tyin-source/Lab-Module-4/docs/module_notes/module_04_high_current_path.md

# Module 4 Part 1: High-Current Path (for instructor inspection)

Source: the Module 3 wiring record in `joshuaaferiat/Lab-Module-3`,
`docs/module_notes/module_03_tec_gui.md` (Part 1). **Before asking for approval,
re-check each item on the physical apparatus.** The actual wiring counts, not
this drawing.

## Diagram

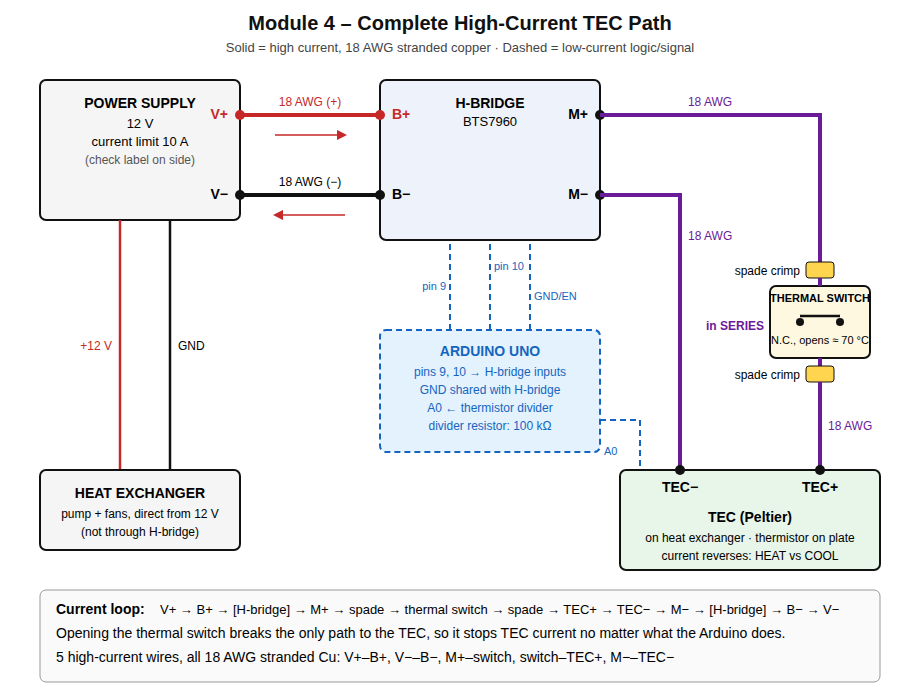
[picture p2: docs/figures/module_04/high_current_path.png]
Complete high-current path


Vector source: `docs/figures/module_04/high_current_path.svg`. Text version:

Solid lines (`│ ─`) carry high current: 18 AWG stranded copper.
Dotted lines (`┊ ┈`) are low-current logic wiring and are not part of the high-current path.

```
        ┌──────────────────────────────────────────┐
        │            POWER SUPPLY                  │
        │   Voltage: 12 V    Current limit: 10 A   │
        │        V+ (+)              V− (−)        │
        └─────────┬───────────────────┬────────────┘
                  │ 18 AWG            │ 18 AWG
                  │                   │
                  ├───────────────────┼──────────► Heat exchanger (pump + fans)
                  │                   │            powered directly from 12 V
                  │                   │            (NOT through H-bridge)
                  ▼                   ▼
        ┌─────── B+ ───────────────── B− ─────────┐
        │                                         │
        │        H-BRIDGE  (BTS7960)              │◄┈┈┈ Arduino pin 9  (PWM/LOW)
        │                                         │◄┈┈┈ Arduino pin 10 (PWM/LOW)
        │                                         │◄┈┈┈ Arduino GND (shared logic ground)
        └─────── M+ ───────────────── M− ─────────┘
                  │ 18 AWG            │ 18 AWG
                  │                   │
            ┌─────┴──────┐            │
            │  [spade]   │            │
            │  THERMAL   │  normally closed,
            │  SWITCH    │  in SERIES with TEC,
            │  (NC)      │  opens at ≈ 70 °C
            │  [spade]   │            │
            └─────┬──────┘            │
                  │ 18 AWG            │
                  ▼                   │
        ┌──────── TEC+ ─────────── TEC− ──────────┐
        │                  TEC                    │
        │      (thermistor plate / heat sink)     │
        └─────────────────────────────────────────┘

Current loop:
  PSU V+ → B+ → [H-bridge] → M+ → thermal switch → TEC+ → TEC → TEC− → M− → [H-bridge] → B− → PSU V−
  (In the other direction, current flows M− → TEC− → TEC → TEC+ → switch → M+.)
```

Opening the thermal switch breaks the M+ → TEC+ leg, so TEC current stops no
matter what the Arduino commands.

## Checklist for the instructor

| Item | Value / what to show | Verified today? |
| --- | --- | --- |
| Wire gauge | 18 AWG stranded Cu on all 5 high-current wires: V+→B+, V−→B−, M+→switch, switch→TEC+, TEC−→M− (the two switch wires end in the spade crimps) | ☑ |
| Supply polarity | V+ → B+, V− → B− | ☑ |
| TEC polarity | M+ → (switch) → TEC+; TEC− → M− | ☑ |
| Spade crimps | Both female spades on the thermal switch are secure (tug test) | ☑ |
| Thermal-switch continuity | Multimeter beeps / reads ≈ 0 Ω across the closed switch | ☑ |
| Thermal-switch placement | In series in the M+ → TEC+ leg, nothing bypasses it | ☑ |
| Supply settings | 12 V, current limit 10 A (check the label on the side of the supply) | ☑ |
| H-bridge outputs checked with TEC power off (Module 3) | Pins 9/10 checked with the scope, TEC power off | ☑ |
| Logic ground | Arduino GND shared with H-bridge logic ground | ☑ |
| Direction mapping | Heating = PWM on pin 9 ; Cooling = PWM on pin 10 (confirmed in the TEC start-up test) | ☑ |

## Module 4 changes from Module 3

| Item | Module 3 | Module 4 |
| --- | --- | --- |
| Thermistor divider external resistor (5 V to A0; thermistor from A0 to GND) | 100 kΩ | **100 kΩ** (unchanged; `SERIES_RESISTOR = 100000.0`) |
| Raw readings averaged per temperature | 200 | 1000 (`ADC_SAMPLES`) |
| Serial update interval | 0.2 s | about 1 s (one line per 1000-reading average) |
| Software temperature limit | none | 60 °C (`TEMP_LIMIT_C`): above it, both H-bridge PWM outputs are set to 0 |
| Measurement line | ends at `Heat/Cool` | adds `, Safety shutdown: 0/1` |
| GUI temperature axis | fixed 15–45 °C | autoscaled to the visible window: 1 °C below the minimum to 1 °C above the maximum, at least a 6 °C span; white background |
| GUI CSV | one file, overwritten each run | a new file per run: `data/module_04/module4_run_<date>_<time>.csv` |

## Files and settings for the module notes

| Item | Value |
| --- | --- |
| Arduino sketch | `arduino/module4_tec_control/module4_tec_control.ino` (9600 baud, 60 °C limit) |
| Interlock test sketch | `arduino/module4_tec_control_limit30_test/module4_tec_control_limit30_test.ino` (identical except 30 °C limit) |
| Python GUI | `python/module4_control_gui.py` |
| Serial port | `COM5` (Windows lab computer; Module 3 recorded `COM4` on Windows and `/dev/cu.usbmodem1101` on macOS) |
| Power-supply voltage | 12 V (from the supply label, recorded in the Module 3 notes) |
| Power-supply current limit | 10 A (from the supply label, recorded in the Module 3 notes) |

## Verifying the software temperature limit (TEC power still OFF)

**Result: done in class.** The 30 °C test sketch was uploaded and the thermistor was warmed by
hand above 30 °C. The serial output switched to `SAFETY SHUTDOWN ACTIVE`, the measurement lines
showed `PWM: 0` and `Safety shutdown: 1`, and both H-bridge PWM outputs were zero. After the
thermistor cooled below 30 °C, PWM stayed at 0 until a new command was sent. The 60 °C sketch
was then uploaded again and shown to the instructor (`SAFETY: software temperature limit (C): 60.00`).
The apparatus was never heated to 60 °C. The hardware thermal switch stays in series as the
independent final protection.

Procedure used:

1. Upload the 30 °C test sketch (`TEMP_LIMIT_C = 30.0`). The GUI terminal shows
   `SAFETY: software temperature limit (C): 30.00`.
2. Set a nonzero PWM (for example 100) in the GUI so there is an output to shut off.
3. Warm the thermistor with your fingers until the averaged temperature passes 30 °C.
4. Confirm that the terminal prints `SAFETY SHUTDOWN ACTIVE ...`, the lines show `PWM: 0`
   and `Safety shutdown: 1`, the GUI banner turns red, and the PWM trace drops to 0.
   Optionally check that pins 9 and 10 both read 0 V.
5. Move the PWM slider: the Arduino keeps `PWM: 0` while the shutdown is active.
6. Let the thermistor cool below 30 °C: the terminal prints `SAFETY SHUTDOWN CLEARED ...`
   and PWM stays 0 until you send a new command.
7. Upload `module4_tec_control.ino` (60 °C) again and show the instructor the `60.00` start-up line.

## TEC start-up test and Part 2 endpoint PWM values (9/30)

Room temperature 22.58 °C. Before the TEC was powered, the apparatus read 25.07 °C and was
slowly falling toward room temperature.

| Direction | PWM | Steady temperature | PWM trace colour | Target, with allowed error |
| --- | --- | --- | --- | --- |
| COOL | 80 | 9.93 °C | blue | 10 °C ± 1 °C: OK |
| HEAT | 47 | 45.24 °C | red | 45 °C ± 2 °C: OK |

These two runs set the maximum useful PWM for each direction (Part 2): HEAT 47 and COOL 80.
The five values per direction are 0, 25, 50, 75 and 100 % of that maximum:
HEAT 0 / 12 / 24 / 35 / 47 and COOL 0 / 20 / 40 / 60 / 80.

## Part 3: Steady-state measurements

### How steady state was decided

The lab's rule: estimate the time constant τ from a PWM step, wait about 3 τ (95 % of the change
is then complete), then watch the trace for one more minute. The temperature counts as steady when
its net drift over that minute is no larger than the ordinary short-term noise. The GUI's
autoscaled temperature axis (at least 6 °C span) was added after these measurements; it makes a
slow drift easier to see in later runs.

`python/steady_state_analysis.py` applies the same rule to a saved run CSV:

1. For each PWM step it fits `T(t) = T_ss + (T_start − T_ss)·exp(−(t − t_step)/τ)` to get τ.
2. Over the last 60 s of the step it fits a straight line. Net drift = |slope| × 60 s, and
   noise = standard deviation of the points about that line.
3. The step is steady when the time waited is at least 3 τ **and** the net drift is at most
   2 × noise (2σ is about the size of the usual up-and-down wiggles).

Run it with `python python/steady_state_analysis.py data/module_04/module4_run_<date>_<time>.csv`.
It prints τ, 3 τ, the time waited, drift, noise and a steady yes/no for every step. A step that
does not change the temperature (for example PWM 0 at the start) has no meaningful τ.

### Criterion actually used

After each PWM step we waited about 3 τ, then watched the trace for one more minute. The
temperature was recorded as steady when it stayed within **±0.1 °C** for that whole minute.
±0.1 °C is about the size of the trace's ordinary short-term noise with 1000-reading averaging, so
this is a concrete form of the lab's rule (net drift over the minute no larger than the noise). If
the trace drifted or fluctuated outside ±0.1 °C, we kept waiting and checked another minute; if it
kept fluctuating (HEAT 24, first attempt), the step was repeated.

Figure caption used in A2:

> Steady state: after each PWM step we waited about three time constants (τ ≲ 100 s), then
> watched the strip chart for one more minute. A temperature was recorded as steady when it stayed
> within ±0.1 °C (about the normal measurement noise) for that whole minute. Waits were 370–725 s.

### Data table

Each step started from the previous step's steady temperature, so each start temperature equals
the steady temperature in the row above. Both directions start from the same zero-PWM state.

| Direction | PWM | Start Temperature (°C) | Steady Temperature (°C) | Time Waited (s) | Notes |
| --- | ---: | ---: | ---: | ---: | --- |
| Heat | 0 | 23.48 | 23.48 | 174 | zero-PWM reference |
| Heat | 12 | 23.48 | 28.90 | 725 |  |
| Heat | 24 | 28.90 | 35.35 | 530 | first attempt kept fluctuating outside ±0.1 °C for 1400 s; the step was retested and reached steady state in about 530 s |
| Heat | 35 | 35.35 | 40.40 | 448 |  |
| Heat | 47 | 40.40 | 46.10 | 494 |  |
| Cool | 0 | 23.48 | 23.48 | 174 | zero-PWM reference |
| Cool | 20 | 23.48 | 20.30 | 372 |  |
| Cool | 40 | 20.30 | 16.82 | 400 |  |
| Cool | 60 | 16.82 | 13.25 | 528 |  |
| Cool | 80 | 13.25 | 9.83 | 370 | repeated after the loose L_EN / LPWM wires were reseated |

Both directions share the same zero-PWM measurement (174 s at PWM 0).

The waits were set by watching the strip chart until the steady-state rule was met,
not by a fixed timer, so they vary from 370 s to 725 s. At HEAT 24 the first attempt kept
fluctuating outside ±0.1 °C even after 1400 s, so that step was retested; the retest reached
steady state in about 530 s, and its value is the one in the table. τ was not fitted separately
for each step. Every step met the rule (about 3 τ plus a final minute with no drift beyond the noise)
within its recorded wait, so the shortest waits (370–372 s) put an upper limit on τ:
3 τ + 60 s ≤ 370 s gives τ ≲ 100 s. To get τ directly, run
`steady_state_analysis.py` on a saved run CSV.

### Why the endpoint test and the step series differ slightly

The Part 2 endpoint test (9/30) and the Part 3 step-by-step series were done on two different days:

| | Part 2 endpoints (9/30) | Part 3 series |
| --- | ---: | ---: |
| Zero-PWM / room reference | room 22.58 °C | zero-PWM steady 23.48 °C |
| COOL PWM 80 | 9.93 °C | 9.83 °C |
| HEAT PWM 47 | 45.24 °C | 46.10 °C |

At steady state `T = T_0 + χ_T·u`, where the zero-PWM temperature `T_0` is set by that day's room
temperature and heat-exchanger conditions. A different day shifts `T_0` and moves the whole
curve up or down, but it does not change how much the temperature moves per PWM count. This does
not affect the results:

- **Part 2 only selected the maximum PWM values.** Both series stay inside the allowed windows on
  both days (10 °C ± 1 °C and 45 °C ± 2 °C), so the same maxima (COOL 80, HEAT 47) apply.
- **All fitted points come from one day.** The slopes m_h and m_c, and their ratio r, are
  differences within the Part 3 series, measured from that day's own `T_0`. A day-to-day offset
  cancels out of them.
- **The differences are small:** 0.10 °C (cool) and 0.86 °C (heat), about what a ~1 °C change
  in room temperature produces.

## Part 4: Steady-state temperature vs PWM

Data: `data/module_04/part4_steady_state.csv`. Script: `python/part4_temp_vs_pwm.py`.
Signed PWM: positive = HEAT, negative = COOL.

Temperature vs signed PWM

| Direction | Signed PWM | Steady temperature (°C) |
| --- | --- | --- |
| COOL | −80 / −60 / −40 / −20 | 9.83 / 13.25 / 16.82 / 20.30 |
| Off | 0 | 23.48 |
| HEAT | 12 / 24 / 35 / 47 | 28.90 / 35.35 / 40.40 / 46.10 |

Linear fits: m_h = 0.485 °C/count (heating), m_c = 0.172 °C/count (cooling), r = m_h / m_c ≈ 2.8.
Both directions are close to linear. Heating is stronger because Joule heating (∝ I²) adds to
the Peltier heat when heating and opposes it when cooling.

These runs were on a different day from the 9/30 endpoint test, so the end points differ
slightly; see "Why the endpoint test and the step series differ slightly" in Part 3.

### Wiring fault found during the measurements

During the cooling measurements, the temperature reading became unstable and drifted, and the PWM
drive to the TEC was intermittent. We first suspected a short circuit. Because the problem was most
obvious in the cooling direction, we checked the logic wiring on the H-bridge's left side. Wiggling
the wires one at a time while running at low PWM showed that both the L_EN wire and the LPWM wire
(Arduino pin 10) were loose. A loose L_EN intermittently disables the left half-bridge, which
interrupts TEC current in both directions. A loose LPWM interrupts only the cooling PWM, because
LPWM is held LOW during heating anyway. Together they explain why the cooling direction was affected
most. After both wires were reseated, the cooling response was stable and the measurements were
repeated. The fault was located with this wiggle test, not confirmed with an oscilloscope.

## Resolved items

1. **Thermal-switch rating: resolved.** The Module 3 notes said 65 °C; the hardware thermal
   switch opens near **70 °C**, as the Module 4 handout states. Two independent protection
   levels: the software limit in the Arduino sketch shuts off both H-bridge PWM outputs above
   **60 °C**, and if the software fails, the normally closed thermal switch in series with the
   TEC opens near **70 °C** and cuts TEC current regardless of the Arduino.
2. **Direction mapping: resolved.** The Module 3 notes say HEAT = PWM on pin 10, but the
   sketch uses `HEAT_ACTIVE_PIN = 9` and `COOL_ACTIVE_PIN = 10`. The Module 4 start-up test
   confirmed the sketch: the PWM trace is red while heating and blue while cooling. The
   Module 3 notes were wrong; no constants were changed.
3. **Baud rate.** The Module 3 README says 115200, but the sketch calls
   `Serial.begin(9600)`. The GUI uses 9600, so they match. The README is just out of date.
4. **Serial port: resolved.** Module 3 recorded `COM4` on Windows, but the lab computer
   used for Module 4 shows the Arduino on `COM5`, which the GUI uses.
