tyin-source/Lab-Module-4/a2/A2.pdf

TEC Heating and Cooling Analysis: Open-Loop Calibration and the Slope Ratio

Tianren Yin
Physics Department, Brandeis University (Dated: October 7, 2026)

We measured the steady-state temperature of a thermoelectric cooler (TEC, Laird CP14-127-045-L2-W4.5) driven by signed PWM through an H-bridge. Both branches are linear, with slopes mh = 0.485 ◦C/count (heating) and mc = 0.172 ◦C/count (cooling), giving r = mh/mc = 2.82. A steady-state energy balance with PWM-averaged current gives Q˙

J /Q˙ P = (r − 1)/(r + 1) = 0.48. The Laird maximum-current data predict rLaird,max = 2.56. We discuss why the two ratios need not agree.

### 1. PART 4: COMBINED GRAPH AND FITS

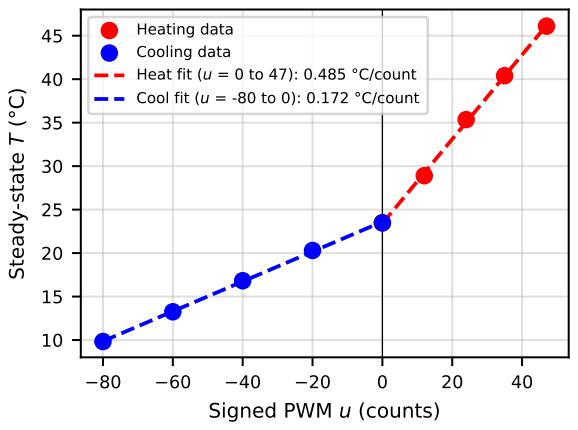
[picture p3: figure]
Signed PWM u (counts); Steady-state T (°C); Heating data

Cooling data Heat fit (u = 0 to 47): 0.485 °C/count

Cool fit (u = -80 to 0): 0.172 °C/count

FIG. 1. Steady-state temperature versus signed PWM u (positive = heating, red; negative = cooling, blue), with a leastsquares line for each branch. Heating fit: u = 0 to 47; cooling fit: u = −80 to 0. Both branches share the u = 0 point (23.48 ◦C). Steady state: after each PWM step we waited about three time constants (τ ≲ 100 s), then recorded the temperature once it stayed within ±0.1

◦C (about the normal
measurement noise) for one further minute. Waits were 370– 725 s.

### 2. PART 5.1: MEASURED SLOPES

Linear fits to the five points of each branch in Fig. 1 give

mh = 0.485 ± 0.007 ◦C/count | (u = 0 to 47), | (1)
mc = 0.172 ± 0.002 ◦C/count | (u = −80 to 0), | (2)

r =

mh
mc

=

0.485
0.172
= 2.82 ± 0.05, | (3)

where the uncertainties are the standard errors of
the fitted slopes. | The duty ranges are D ≤ 0.184
(heating) and D ≤ 0.314 (cooling). | Neither branch
shows visible curvature: | the slopes between neigh-
bouring points are 0.45, 0.54, 0.46, 0.48 (heating) and 0.17, 0.18, 0.17, 0.16 ◦C/count (cooling), with no systematic trend. We therefore fitted one straight line to all five points of each branch, from 0 to that direction’s maximum useful PWM.

### 3. PART 5.2: PWM AND THE SLOPE-RATIO

MODEL

Steady-state balance. At steady state G(T − T0) = Q˙ TEC. Q˙ TEC holds the two current-dependent object-face terms: Peltier transport (into the object when heating, out of it when cooling) and object-face Joule heating 1/2 I

2RM (always into the object). G(T − T0) is the net passive heat flow out of the object, including conduction back through the TEC. When heating (T > T0) it flows out; when cooling (T < T0) it flows in. The individual flows are not zero; their sum is.
PWM averages. In one period τ the current is I for Dτ and 0 for (1 − D)τ , so

⟨I⟩ =

1
τ

"Z Dτ

0

I dt +

Z τ

Dτ

0 dt#
= DI, | (4)

⟨I

2
⟩ =

1
τ

Z Dτ

0

I

2

dt = DI²
. | (5)

Because the current is either full or zero, ⟨I

2

⟩ = DI² ̸=
⟨I⟩

2 = D²
I

2
for 0 < D < 1. Both terms are therefore linear in D, and the model predicts a straight line on each branch with a kink at u = 0, as our graph shows. With ⟨I

2

⟩ = D²
I

2
(as for DC), the heating branch would curve upward and the cooling branch would flatten. This assumes the PWM period (≈ 2 ms) is much shorter than the thermal time constant, so the block responds only to the averages.
Slope ratio. With signed duty d = u/255 and D = |d|, Q˙ TEC = d Q˙

P + |d| Q˙
J . For heating (d > 0, |d| = d) and cooling (d < 0, |d| = −d), the steady-state balance

2

gives

Th − T0 =

d(Q˙

P + Q˙
J )
G

,

dTh
dd =

Q˙

P + Q˙
J
G

, (6)

Tc − T0 =

d(Q˙

P − Q˙
J )
G

,

dTc
dd =

Q˙

P − Q˙
J
G

. (7)

Both slopes are positive when Q˙

P > Q˙
J , and the heating slope is larger. Since m = dT /du =

1
255 dT /dd, the
factors 1/255 and G cancel:

r =

mh
mc

=

Q˙

P + Q˙
J
Q˙

P − Q˙
J
. | (8)

Let x = Q˙

J /Q˙
P . Then r = (1 + x)/(1 − x), so r − rx = 1 + x and r − 1 = x(r + 1):

Q˙
J
Q˙
P

=

r − 1
r + 1

=

2.82 − 1
2.82 + 1

= 0.48 ± 0.01. (9)

(Check: r = 2 gives 1/3.) At our on-state current, the object-face Joule heat is about half of the Peltier heat pumping.

### 4. PART 5.3: LAIRD DATA-SHEET

CALCULATION

Table I lists the values from the Laird CP14-127-045-L2-W4.5 data sheet (Rev. 00, 06-01-2022), p. 3, Specifications table, hot-side temperature Th = 27.0

◦C column.

TABLE I. Laird data-sheet values at Th = 27 ◦C.

Quantity Value | Meaning and condition
RM | 1.50 Ω Module electrical resistance.
Imax | 8.6 A | Current giving ∆Tmax; Qc = 0.
Qc,max | 71.3W Max cold-side heat; Imax, ∆T = 0.
∆Tmax | 70.5

◦C Max hot-to-cold difference; Imax, Qc = 0.

At ∆T = 0 the conduction term is zero, and half of the Joule heat goes to the object face:

Q˙
J,max =

1/2 I

2
maxRM =

1/2(8.6 A)²
(1.50 Ω)
= 55.5 A² Ω = 55.5 W, | (10)

Q˙

P,max = Qc,max + Q˙
J,max = 71.3 + 55.5 = 126.8 W, (11)

rLaird,max =

Q˙

P,max + Q˙
J,max
Q˙

P,max − Q˙
J,max

=

182.3
71.3

= 2.56. (12)

At Imax this corresponds to Q˙

J /Q˙
P = 55.5/126.8 = 0.44.

### 5. PART 5.4: COMPARE THE RATIOS

Measured: r = 2.82 (Q˙

J /Q˙
P = 0.48). Laird at Imax:
r = 2.56 (0.44). The measured ratio is about 10 % higher, which is similar but not equal. Exact agreement is not expected:

D = 1 does not mean I = Imax. Full duty only keeps the H-bridge on. The on-state current is set by the 12 V supply, the H-bridge and wiring drops, RM, and the TEC’s Seebeck back-voltage. That gives at most 12 V/1.50 Ω ≈ 8 A and in practice less, below Imax = 8.6 A. The 10 A supply limit is not reached.

The Joule fraction scales with current: Q˙

J /Q˙
P =
1/2 I

2RM/(SMToI) ∝ I. A lower current alone would make r smaller than 2.56, so the excess comes from the effects below.

Peltier term ∝ To (kelvin). The object face averages ≈ 308 K on the heating branch and ≈ 290 K on the cooling branch, so Peltier pumping is relatively stronger when heating. This raises r.

Finite ∆T, PWM, changing properties. The data sheet is for steady DC at ∆T = 0. Our object face spans 10–46 ◦C, which changes TEC conduction and the back-voltage. RM itself rises from 1.50 to 1.68 Ω between 27 and 50 ◦C (same table), and SM and KM also vary.

Passive paths and fitting. If the leaks are not equal above and below room temperature, G does not cancel exactly. One straight line per branch also averages over any slight curvature.

### 6. PART 5.4: PASSIVE CONDUCTION

When the object is hotter than its surroundings (heating), passive heat flows out of the object; when it is colder (cooling), passive heat flows into it. Either way it pulls the temperature back toward T0, so it opposes both heating and cooling. Approximately symmetric conduction enters both branches through the same G. It reduces both slopes by the same factor 1/G, which cancels from
r. Without Joule heating the two branches would be ±Q˙
P /G, equal in magnitude. The unequal slopes come from Joule heating, which keeps its sign when the current reverses: it adds to Peltier heating and subtracts from Peltier cooling.
