tyin-source/Lab-Module-4/(commit log)

2026-09-30 Show Arduino safety-shutdown status in Module 4 GUI
    Parse an optional trailing 'Safety shutdown: 0/1' field, show a red
    banner when active, echo SAFETY lines to the terminal, and log the flag
    to CSV. Module 3 output without the field still parses (treated as 0).
    Claude-Session: https://claude.ai/code/session_01PEHAh8ir7Rzr8VMQrsMfe5
2026-09-30 Add Module 4 high-current path diagram and inspection checklist
    Filled in from the Module 3 wiring record (12 V / 10 A supply, BTS7960,
    thermal switch in series on the M+ -> TEC+ leg, 18 AWG leads) and flags
    open discrepancies to resolve before instructor sign-off.
    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
2026-09-30 Add drawn high-current path diagram and drop committed bytecode
    Adds an SVG/PNG drawing of the supply -> BTS7960 -> thermal switch -> TEC
    loop (with the Arduino logic wiring and heat exchanger branch shown
    separately), embeds it in the Module 4 notes, corrects the high-current
    wire count to 5, and removes an accidentally committed .pyc file.
    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
2026-09-30 Add Module 3 serial-command sketch as starting point for Module 4
    Unmodified copy of arduino/tec_python_control/tec_python_control.ino from
    Lab-Module-3, so the Module 4 changes show up as a reviewable diff.
    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
2026-09-30 Use 48.00 kOhm thermistor divider resistor for Module 4
    The external divider resistor was changed from 100 kOhm (Module 3) to
    48.00 kOhm. Update SERIES_RESISTOR in the sketch and record the change in
    the Module 4 notes and wiring diagram.
    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
2026-09-30 Add software temperature limit and 1000-reading average to Module 4 sketch
    - Average 1000 raw ADC readings per temperature (Module 2 sequence),
    one reading per ms, so a new line prints about once a second. The
    readings are spread across loop() so serial commands stay responsive.
    - Named constant TEMP_LIMIT_C = 60.0. Every loop, if the averaged
    temperature is above it (or invalid), both H-bridge PWM outputs are
    set to zero and new commands cannot turn them back on. The commanded
    PWM is cleared, so the TEC does not restart by itself afterwards.
    - Serial output keeps running, adds ", Safety shutdown: 0/1" to each
    measurement line, prints SAFETY SHUTDOWN ACTIVE/CLEARED messages, and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
2026-09-30 Use 0.825 kOhm thermistor divider resistor
    SERIES_RESISTOR = 825.0, replacing 48.00 kOhm; notes and diagram updated.
    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
2026-09-30 Revert thermistor divider resistor to 48.00 kOhm
    Undo the 0.825 kOhm change; SERIES_RESISTOR is 48000.0 again.
    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
    [module4_tec_control.ino]
2026-09-30 Use 100 kOhm thermistor divider resistor
    SERIES_RESISTOR = 100000.0 (same as Module 3), replacing 48.00 kOhm;
    notes and diagram updated.
    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
2026-09-30 Record TEC start-up test and confirmed heat/cool pin mapping
    Low-PWM test: COOL PWM 80 -> 9.8-9.9 C (blue trace), HEAT PWM 47 ->
    45.2 C (red trace), both within the allowed error. This confirms
    HEAT_ACTIVE_PIN = 9 / COOL_ACTIVE_PIN = 10; the Module 3 notes were wrong.
    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
    [module4_tec_control.ino]
2026-10-07 Add Part 4 steady-state temperature vs PWM data, plot, and wiring fault note
    Steady temperatures for signed PWM -80..47 with per-direction linear fits
    (m_h = 0.485, m_c = 0.172 C/count, r = 2.8), the plotting script and
    figure, and the loose L_EN / LPWM wiring fault found while measuring.
    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
    [part4_steady_state.csv]
2026-10-07 Add GUI autoscaling, 30 C interlock test sketch, and Part 3 steady-state analysis
    - GUI: temperature axis autoscales to the visible window (1 C margin,
    at least 6 C span) on a white background; PWM axis unchanged. Each
    run writes its own timestamped CSV instead of overwriting one file.
    - 30 C test version of the sketch used for the Part 1 interlock test,
    with the test result recorded in the notes.
    - steady_state_analysis.py: fits the time constant for each PWM step
    and applies the 3-tau + 60 s drift-vs-noise steady-state rule.
    - Notes: serial port and supply settings, Part 2 endpoint values,
    Part 3 method and table, and why the two measurement days differ
    only by an offset that d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
    [module4_control_gui.py, module4_tec_control_limit30_test.ino, steady_state_analysis.py]
2026-10-07 Record Part 3 waiting times and the resulting time-constant bound
    Fill the Time Waited column (174-1400 s) in the notes table and the
    Part 4 CSV, add start temperatures to the CSV, and note that the
    shortest waits imply tau <~ 100 s.
    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
    [part4_steady_state.csv]
2026-10-07 Record the +-0.1 C steady-state criterion and the repeated HEAT 24 step
    The steady-state rule used in class: wait about 3 tau, then require the
    temperature to stay within +-0.1 C (about the short-term noise) for one
    more minute. HEAT 24 fluctuated in the first 1400 s attempt and was
    repeated (about 530 s). Adds the A2 figure caption.
    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
    [part4_steady_state.csv]
2026-10-07 Record the HEAT 24 retest (about 530 s) in the Part 3 notes
    The first HEAT 24 attempt kept fluctuating outside +-0.1 C for 1400 s
    and was repeated; the retest reached steady state in about 530 s. Use
    530 s in the table and caption (waits now 370-725 s). The previous
    commit changed only the CSV.
    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
2026-10-07 Restore the Part 4 heading in the Module 4 notes
    An earlier insertion of the Part 3 section replaced the Part 4 heading.
    Also point the Part 4 two-day remark at the Part 3 explanation, and note
    that the autoscaled GUI axis was added after the measurements.
    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
2026-10-07 Mark instructor checklist complete and record the 70 C thermal switch
    All Part 1 inspection items confirmed. The hardware thermal switch opens
    near 70 C (not 65 C as the Module 3 notes said); the 60 C software limit
    is the first protection level. Diagram updated.
    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
2026-10-07 Add the A2 LaTeX project
    a2/A2.tex covers items 1-6 of the A2 assignment in two pages: the
    combined graph with fit ranges and steady-state caption, measured slopes
    with standard errors, the PWM averaging proof and slope-ratio derivation,
    the Laird data-sheet calculation, and the comparison and passive-conduction
    discussion. a2/make_figure.py builds the graph from the Part 3 data.
    The compiled A2.pdf is included.
    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
2026-10-07 Switch A2 to the REVTeX 4.2 (APS reprint) format
    Two-column revtex4-2 layout with title, author (Tianren Yin, Brandeis
    University), abstract, and the six numbered A2 sections. The figure is
    resized for one column. Still two pages.
    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
2026-10-07 Show the A^2 Ohm = W unit step in the A2 Joule-heat calculation
    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
